KazanNinja/ESP32-Proto/README.md

Proof of concept ESP32-Proto board code.

Currently grabs gear position, engine speed, coolant temperature, and pit limiter switch through CAN and does magical electric stuff with it.
