KazanNinja/ESP32-Proto/Kicad/ESP32-Proto.kicad_pcb

## KiCad design Kicad/ESP32-Proto.kicad_pcb (2025-08-27)

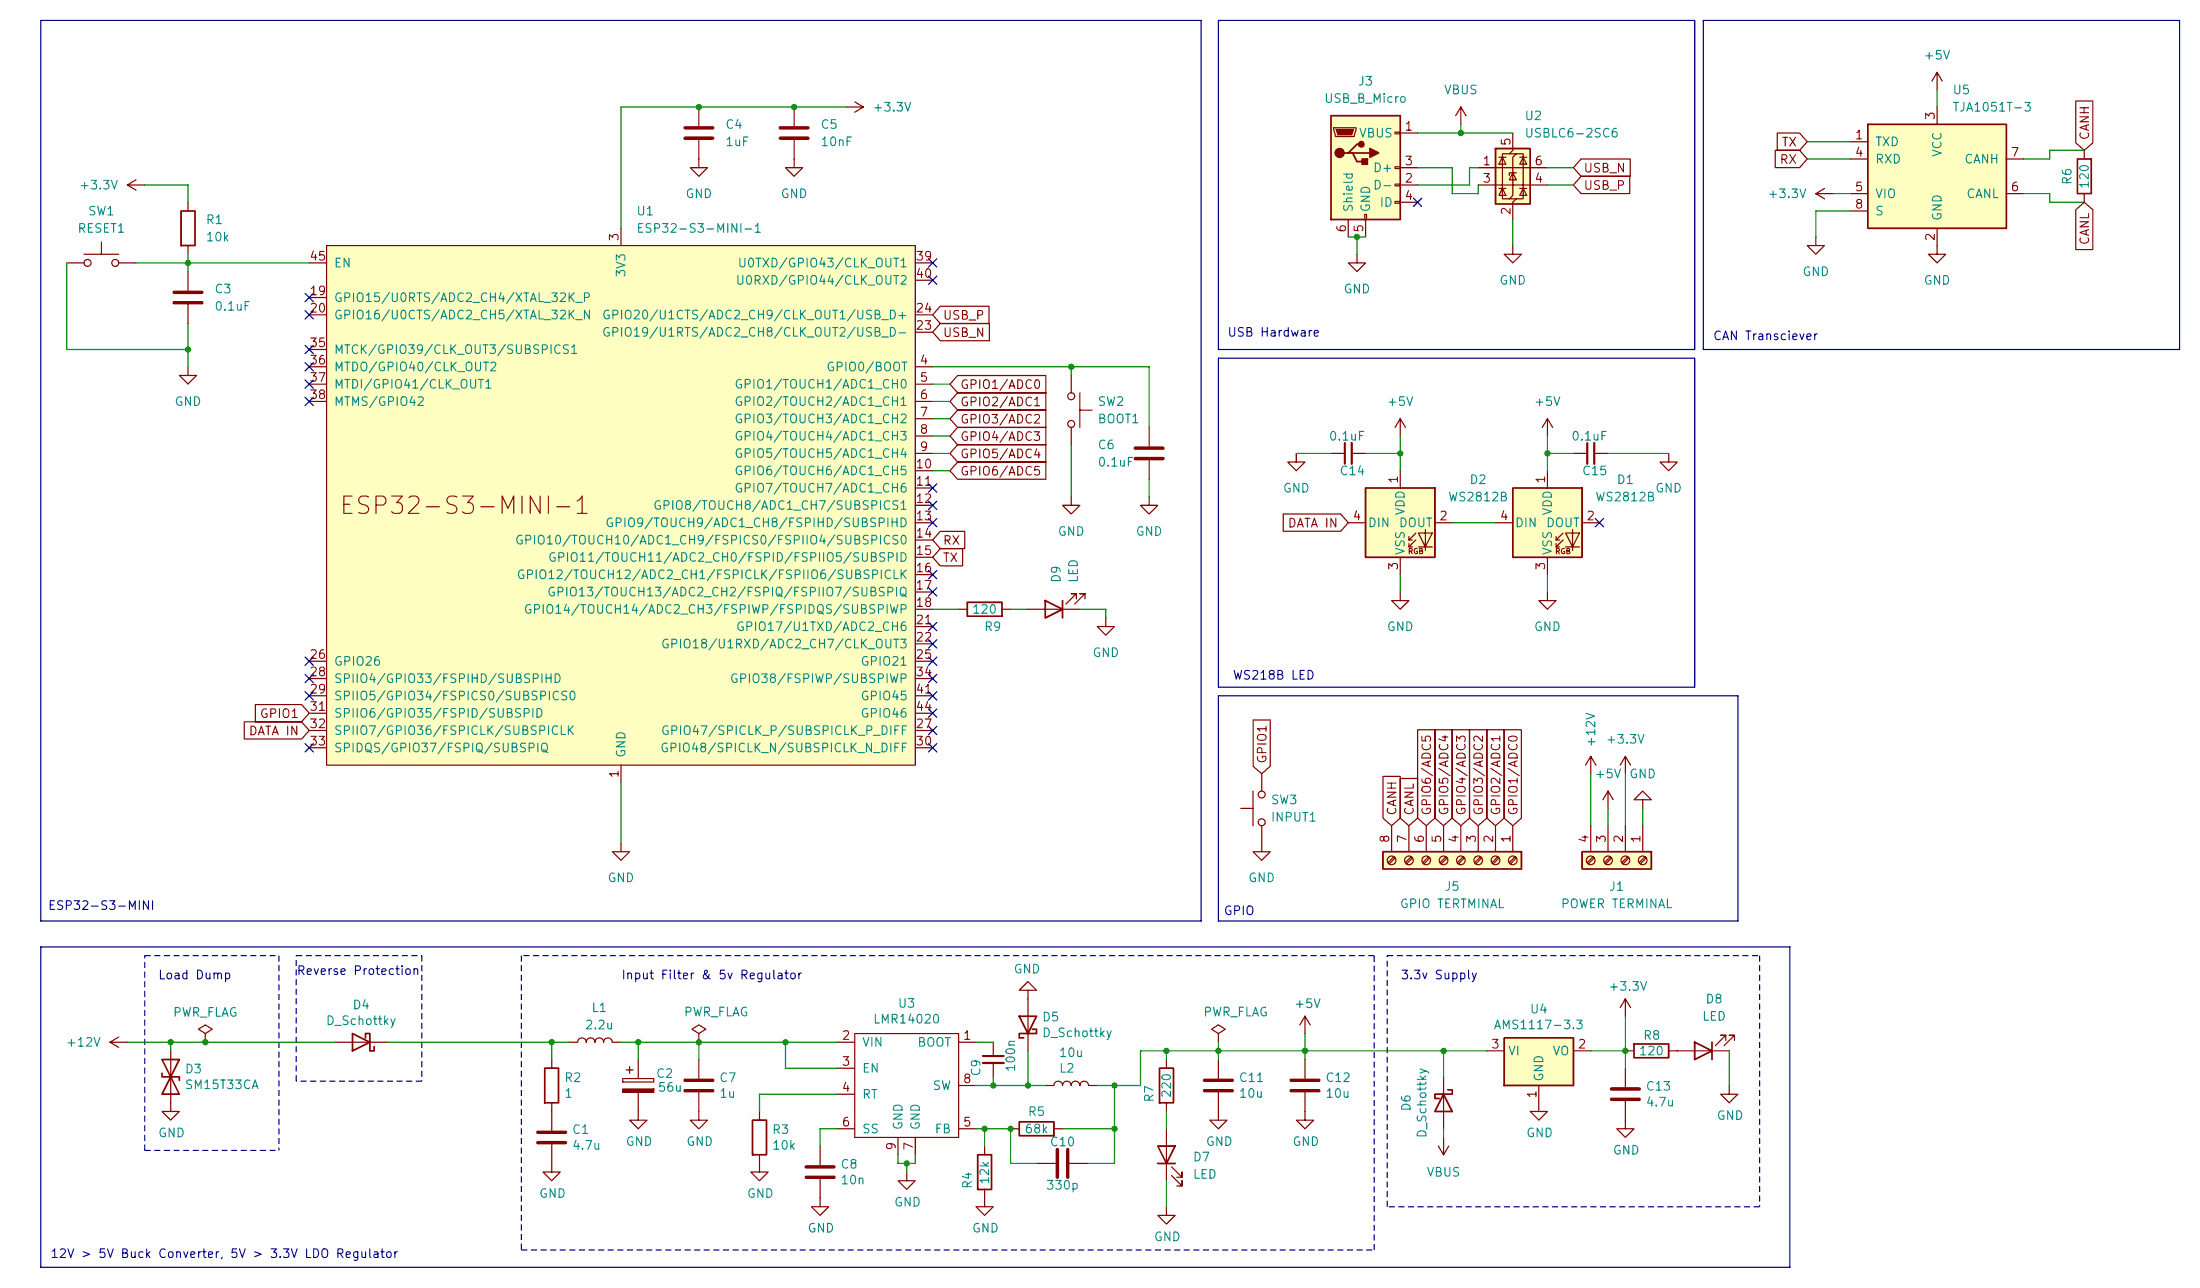
[picture p1: schematic ESP32-Proto.kicad_sch]

Parts:
C1, C13: 4.7u; C_0603_1608Metric; LCSC C19666
C2: 56u; CP_Radial_D8.0mm_P2.50mm
C3, C6: 0.1uF; C_0603_1608Metric
C4: 1uF; C_0603_1608Metric
C5: 10nF; C_0603_1608Metric
C7: 1u; C_0603_1608Metric; LCSC C15849
C8: 10n; C_0603_1608Metric; LCSC C57112
C9: 100n; C_0603_1608Metric; LCSC C14663
C10: 330p; C_0603_1608Metric; LCSC C1664
C11, C12: 10u; C_1206_3216Metric; LCSC C13585
C14, C15: 0.1uF; C_0603_1608Metric; LCSC C14663
D1, D2: WS2812B; LED_WS2812B_PLCC4_5.0x5.0mm_P3.2mm
D3: SM15T33CA; D_SMC; LCSC C151281
D4, D5, D6: D_Schottky; D_SMA; LCSC C8678
D7, D8, D9: LED; LED_0805_2012Metric; JLCPCB C2297
J1: POWER TERMINAL; TerminalBlock_Phoenix_MKDS-1,5-4_1x04_P5.00mm_Horizontal
J3: USB_B_Micro; USB_Micro-B_Amphenol_10103594-0001LF_Horizontal
J5: GPIO TERTMINAL; TerminalBlock_Phoenix_PT-1,5-8-3.5-H_1x08_P3.50mm_Horizontal
L1: 2.2u; L_1210_3225Metric; LCSC C286757
L2: 10u; L_Sunlord_MWSA0503S; LCSC C408412
R1: 10k; R_0603_1608Metric
R2: 1; R_0603_1608Metric; LCSC C22936
R3: 10k; R_0603_1608Metric; LCSC C25804
R4: 12k; R_0603_1608Metric; LCSC C22790
R5: 68k; R_0603_1608Metric; LCSC C23231
R6, R8, R9: 120; R_0603_1608Metric; LCSC C22787
R7: 220; R_0603_1608Metric; LCSC C22962
SW1: RESET1; SW_SPST_TL3342
SW2: BOOT1; SW_SPST_TL3342
SW3: INPUT1; SW_SPST_TL3342
U1: ESP32-S3-MINI-1; ESP32-S3-MINI-1U
U2: USBLC6-2SC6; SOT-23-6
U3: LMR14020; SOIC-8-1EP_3.9x4.9mm_P1.27mm_EP2.29x3mm; LCSC C187824
U4: AMS1117-3.3; SOT-223-3_TabPin2; LCSC C6186
U5: TJA1051T-3; SOIC-8_3.9x4.9mm_P1.27mm

Connections:
+3.3V: C4.1, C5.1, C13.1, J1.2, R1.1, R8.2, U1.3 (3V3), U4.2 (VO), U5.5 (VIO)
+5V: C10.1, C11.1, C12.1, C14.2, C15.1, D1.1 (VDD), D2.1 (VDD), D6.1 (K), J1.3, L2.2, R5.2, R7.1, U4.3 (VI), U5.3 (VCC)
+12V: D3.1 (A1), D4.2 (A), J1.4
CANH: J5.8, R6.2, U5.7 (CANH)
CANL: J5.7, R6.1, U5.6 (CANL)
DATA IN: D2.4 (DIN), U1.32 (SPIIO7/GPIO36/FSPICLK/SUBSPICLK)
GND: C1.2, C2.2, C3.2, C4.2, C5.2, C6.2, C7.2, C8.2, C11.2, C12.2, C13.2, C14.1, C15.2, D1.3 (VSS), D2.3 (VSS), D3.2 (A2), D5.2 (A), D7.1 (K), D8.1 (K), D9.1 (K), J1.1, J3.5 (GND), J3.6 (Shield), R3.2, R4.2, SW1.2, SW2.2, SW3.1, U1.1 (GND), U1.2 (GND), U1.42 (GND), U1.43 (GND), U1.46 (GND), U1.47 (GND), U1.48 (GND), U1.49 (GND), U1.50 (GND), U1.51 (GND), U1.52 (GND), U1.53 (GND), U1.54 (GND), U1.55 (GND), U1.56 (GND), U1.57 (GND), U1.58 (GND), U1.59 (GND), U1.60 (GND), U1.61 (GND), U1.62 (GND), U1.63 (GND), U1.64 (GND), U1.65 (GND), U2.2 (GND), U3.7 (GND), U3.9 (GND), U4.1 (GND), U5.2 (GND), U5.8 (S)
GPIO1: SW3.2, U1.31 (SPIIO6/GPIO35/FSPID/SUBSPID)
GPIO1/ADC0: J5.1, U1.5 (GPIO1/TOUCH1/ADC1_CH0)
GPIO2/ADC1: J5.2, U1.6 (GPIO2/TOUCH2/ADC1_CH1)
GPIO3/ADC2: J5.3, U1.7 (GPIO3/TOUCH3/ADC1_CH2)
GPIO4/ADC3: J5.4, U1.8 (GPIO4/TOUCH4/ADC1_CH3)
GPIO5/ADC4: J5.5, U1.9 (GPIO5/TOUCH5/ADC1_CH4)
GPIO6/ADC5: J5.6, U1.10 (GPIO6/TOUCH6/ADC1_CH5)
unnamed: C1.1, R2.2
unnamed: D1.4 (DIN), D2.2 (DOUT)
unnamed: D4.1 (K), L1.1, R2.1
unnamed: C9.2, D5.1 (K), L2.1, U3.8 (SW)
unnamed: D7.2 (A), R7.2
unnamed: D8.2 (A), R8.1
unnamed: D9.2 (A), R9.2
unnamed: J3.3 (D+), U2.3 (I/O2)
unnamed: J3.2 (D-), U2.1 (I/O1)
unnamed: C3.1, R1.2, SW1.1, U1.45 (EN)
unnamed: C6.1, SW2.1, U1.4 (GPIO0/BOOT)
unnamed: R9.1, U1.18 (GPIO14/TOUCH14/ADC2_CH3/FSPIWP/FSPIDQS/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)
unnamed: C9.1, U3.1 (BOOT)
unnamed: C2.1, C7.1, L1.2, U3.2 (VIN), U3.3 (EN)
unnamed: C10.2, R4.1, R5.1, U3.5 (FB)
unnamed: R3.1, U3.4 (RT)
unnamed: C8.1, U3.6 (SS)
RX: U1.14 (GPIO10/TOUCH10/ADC1_CH9/FSPICS0/FSPIIO4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), U5.4 (RXD)
TX: U1.15 (GPIO11/TOUCH11/ADC2_CH0/FSPID/FSPIIO5/S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), U5.1 (TXD)
USB_N: U1.23 (GPIO19/U1RTS/ADC2_CH8/CLK_OUT2/USB_D-), U2.6 (I/O1)
USB_P: U1.24 (GPIO20/U1CTS/ADC2_CH9/CLK_OUT1/USB_D+), U2.4 (I/O2)
VBUS: D6.2 (A), J3.1 (VBUS), U2.5 (VBUS)

Notes on the sheet:
GPIO
Input Filter & 5v Regulator
Reverse Protection
WS218B LED
3.3v Supply
12V > 5V Buck Converter, 5V > 3.3V LDO Regulator
Load Dump
ESP32-S3-MINI
CAN Transciever
USB Hardware

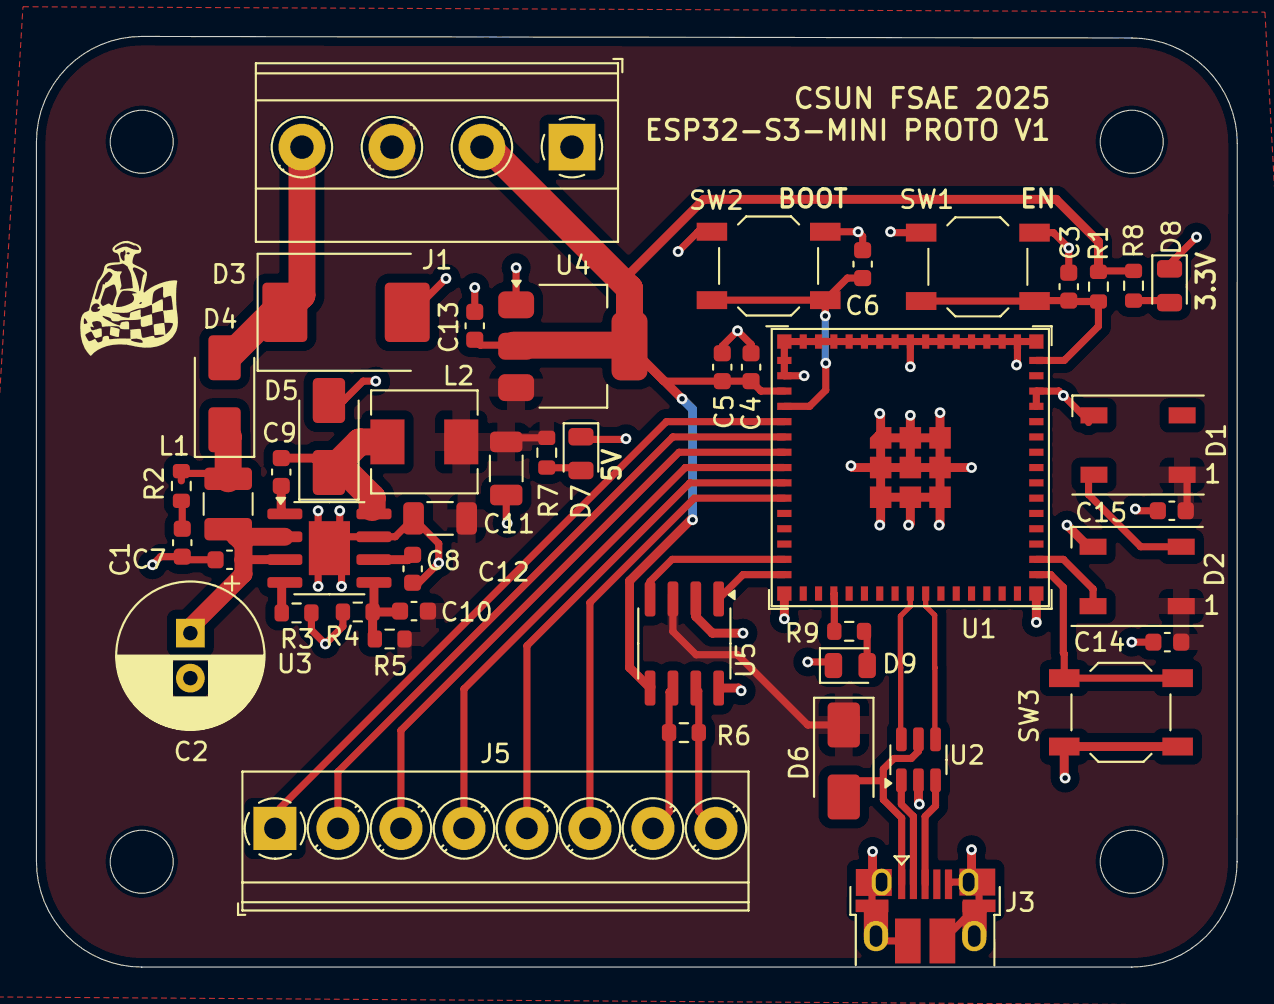
[picture p2: board ESP32-Proto.kicad_pcb from above]

Board: 2 copper layers, 66.7 x 51.7 mm, 46 parts (0 on the bottom side), 36 nets.
