KazanNinja/ESP32-Proto/Kicad/ESP32-Proto_OG_PSU.kicad_pcb

## KiCad design Kicad/ESP32-Proto_OG_PSU.kicad_pcb (2025-08-27)

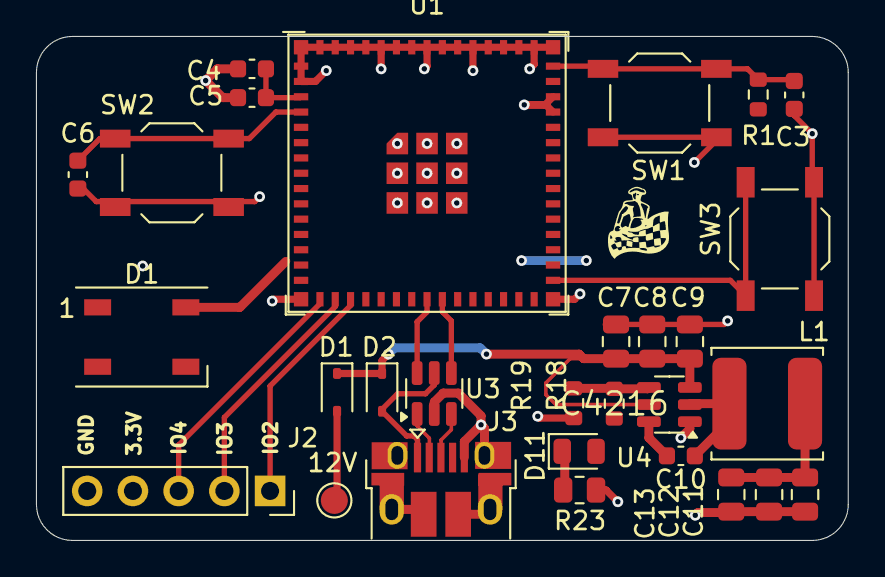
[picture p3: board ESP32-Proto_OG_PSU.kicad_pcb from above]

Board: 2 copper layers, 45.1 x 28.0 mm, 29 parts (0 on the bottom side), 19 nets.

Parts:
12V: TestPoint_Pad_D1.5mm
C3, C6: 0.1uF; C_0603_1608Metric
C4: 1uF; C_0603_1608Metric
C5: 10nF; C_0603_1608Metric
C7: 0.1uF; C_0805_2012Metric
C8, C9: 10uF; C_0805_2012Metric
C10: 100nF; C_0603_1608Metric
C11, C12, C13: 22uF; C_0805_2012Metric
D1, D2: D_Schottky; D_SOD-323
D1#2: WS2812B; LED_WS2812B_PLCC4_5.0x5.0mm_P3.2mm
D11: LED; LED_0805_2012Metric
J2: Conn_01x05_Pin; PinSocket_1x05_P2.54mm_Vertical
J3: USB_B_Micro; USB_Micro-B_Amphenol_10103594-0001LF_Horizontal
L1: 3.3uH; L_TDK_VLS6045EX_VLS6045AF
R1, R19: 10k; R_0603_1608Metric
R18: 33k; R_0603_1608Metric
R23: 100; R_0805_2012Metric
SW1: RESET1; SW_SPST_TL3342
SW2: BOOT1; SW_SPST_TL3342
SW3: INPUT1; SW_SPST_TL3342
U1: ESP32-S3-MINI-1; ESP32-S3-MINI-1U
U3: USBLC6-2SC6; SOT-23-6
U4: TPS562200; SOT-23-6

Connections:
+3.3V: C4.1, C5.1, C11.1, C12.1, C13.1, D11.2 (A), J2.4, L1.2, R1.1, R18.2, U1.3 (3V3)
+12V: 12V.1, D1.2 (A)
GND: C3.2, C4.2, C5.2, C6.2, C7.2, C8.2, C9.2, C11.2, C12.2, C13.2, D1#2.3 (VSS), J2.5, J3.5 (GND), J3.6 (Shield), R19.2, R23.2, SW1.2, SW2.2, SW3.1, U1.1 (GND), U1.2 (GND), U1.42 (GND), U1.43 (GND), U1.46 (GND), U1.47 (GND), U1.48 (GND), U1.49 (GND), U1.50 (GND), U1.51 (GND), U1.52 (GND), U1.53 (GND), U1.54 (GND), U1.55 (GND), U1.56 (GND), U1.57 (GND), U1.58 (GND), U1.59 (GND), U1.60 (GND), U1.61 (GND), U1.62 (GND), U1.63 (GND), U1.64 (GND), U1.65 (GND), U3.2 (GND), U4.1 (GND)
GPIO1: SW3.2, U1.31 (SPIIO6/GPIO35/FSPID/SUBSPID)
GPIO2: J2.1, U1.18 (GPIO14/TOUCH14/ADC2_CH3/FSPIWP/FSPIDQS/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)
GPIO3: J2.2, U1.17 (GPIO13/TOUCH13/ADC2_CH2/FSPIQ/FSPIIO7/S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)
GPIO4: J2.3, U1.16 (GPIO12/TOUCH12/ADC2_CH1/FSPICLK/FSPIIO6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)
unnamed: C7.1, C8.1, C9.1, D1.1 (K), D2.1 (K), U4.3 (VIN), U4.5 (EN)
unnamed: D11.1 (K), R23.1
unnamed: J3.3 (D+), U3.3 (I/O2)
unnamed: J3.2 (D-), U3.1 (I/O1)
unnamed: C3.1, R1.2, SW1.1, U1.45 (EN)
unnamed: C6.1, SW2.1, U1.4 (GPIO0/BOOT)
unnamed: C10.1, L1.1, U4.2 (SW)
unnamed: C10.2, U4.6 (VBST)
unnamed: R18.1, R19.1, U4.4 (VFB)
USB_N: U1.23 (GPIO19/U1RTS/ADC2_CH8/CLK_OUT2/USB_D-), U3.6 (I/O1)
USB_P: U1.24 (GPIO20/U1CTS/ADC2_CH9/CLK_OUT1/USB_D+), U3.4 (I/O2)
VBUS: D2.2 (A), J3.1 (VBUS), U3.5 (VBUS)
