KazanNinja/ESP32-Proto/(commit log)

2024-12-24 Added/Removed Features
    Removed gear switch statement, added RPM fade light thing.
2025-08-27 Kicad Files
    [BOM-ESP32-Proto.csv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]
